ece492g1/smart-bandage/Docs/UIMockup.pdf

Logo

Email

Password

Login

Login Page

First Page of the Smart Bandage App.

Will be set up so that either the nurse or

the patient will need to enter their credentials
and the bandage ID in order to access the
information. This will provide a level of
protection of personal info in case the

phone somehow gets stolen.

Main Page BLE connection

Scan

BLE devices
Connect

Page to ensure that the Bluetooth

is connected, could probably keep
it pretty much how Jared had it.

Bandage ID

# Legend

# Smart Bandage Android Application

Box to enter requested information

Button to click

Advanced View
Temperature:
Moisture:

<Bandage ID>

Temperature reading
Moisture Level

Bandage readings are displayed here.
The temperatures will be displayed in

degrees celcius. The moisture levels will

be converted to "very dry", "dry", "damp",
"wet", "very wet". Where damp would be

the ideal moisture of the wound.

Advanced View

The advanced view would lead

into the "engineering mode" of the

app which would display the bluetooth

characteristics and the raw data.
