ece492g1/smart-bandage/(threads)

Thread 10 (2016-02-09):

Implement GATT Profiles

Mobius5150, 2016-02-09:
Setup the GATT profile with all necessary information to allow for Bluetooth communication, and test that this information can be properly read from the Android device.

Service UUID: `0xF0F0`

Service Characteristics:
 - [ ] `0xF0F1` Temperatures - RO array of 16bit integers representing 16x the temperature
 - [ ] `0xF0F2` Humidity - RO array of 16bit integers representing 16x the humidity %
 - [ ] `0xF0F3` Bandage ID - RO 16bit integer with the ID of the bandage module. `0` means no bandage detected.
 - [ ] `0xF0F4` Bandage State - RO 16bit state value with each bit representing failures on the bandage. `0` for no failure.
 - [ ] `0xF0F5` Battery Charge % - RO 16bit integer representing 16x the battery charge percentage
 - [ ] `0xF0F6` External Power - RO boolean value indicating the presence of external power
 - [ ] `0xF0F7` Moisture Map - RO array of 16bit integers representing 16x the moisture %
 - [ ] `0xF0F8` System Time - R/W 32bit integer giving system time since Unix epoch

Closed 2016-02-17.

Thread 11 (2016-02-09):

MCU Bluetooth Communications

Mobius5150, 2016-02-09:
Implement MCU Bluetooth communications. Depends on #10 being complete.

Implementation should support a handshake for confirmation of correct operation, followed by transmission of sensor data.

Closed 2016-03-02.

Thread 5 (2016-02-09):

Implement multi-threaded I2C Stack

Mobius5150, 2016-02-09:
The I2C stack should be implemented in a way that permits multi-threaded access to I2C devices.

This implies an ability to chain together any number of read and write operations to be executed sequentially in order to provide maximum compatibility with various devices. A datastructure that allows this is necessary for a multi-threaded approach.

Closed 2016-02-16.

Thread 7 (2016-02-09):

Implement HDC1050 Interface

Mobius5150, 2016-02-09:
Implement the interface for the HDC1050 Temperature + Humidity sensor using the I2C stack (#5)

This deliverable will be in two parts. The first part is due Feb 23 and requires writing the code to interface with the device from information from the datasheet, but without actually having the physical device to test with. The second is due after boards are received and the physical device can be used to test the implementation.
 - [ ] Write code and interfaces for managing the HDC1050 from datasheet information. Does not included any testing.
 - [ ] Test the implementation with physical hardware.

Closed 2016-02-29.

Thread 17 (2016-02-17):

Add I2C timeout

Mobius5150, 2016-02-17:
Add a timeout component to the I2C stack to kill a transaction if it takes too long, and then try again.

Somewhere in there there probably needs to be support for power cycling I2C devices in a bad state.

This can happen if the I2C device the MCU has addressed is not connected, or if it is in a bad state (perhaps due to a badly timed MCU reset)

Closed 2016-02-29.

Thread 31 (2016-03-16):

Add externally powered state

Mobius5150, 2016-03-16:
The device could use a state for when it is externally powered (e.g. through the USB charge port). In this state the device will constantly perform sensor readings while simultaneously being available over bluetooth.
