ece492g1/smart-bandage/hardware/bandage_module/Bandage FPC.brd

## EAGLE design hardware/bandage_module/Bandage FPC.brd (2016-03-18)

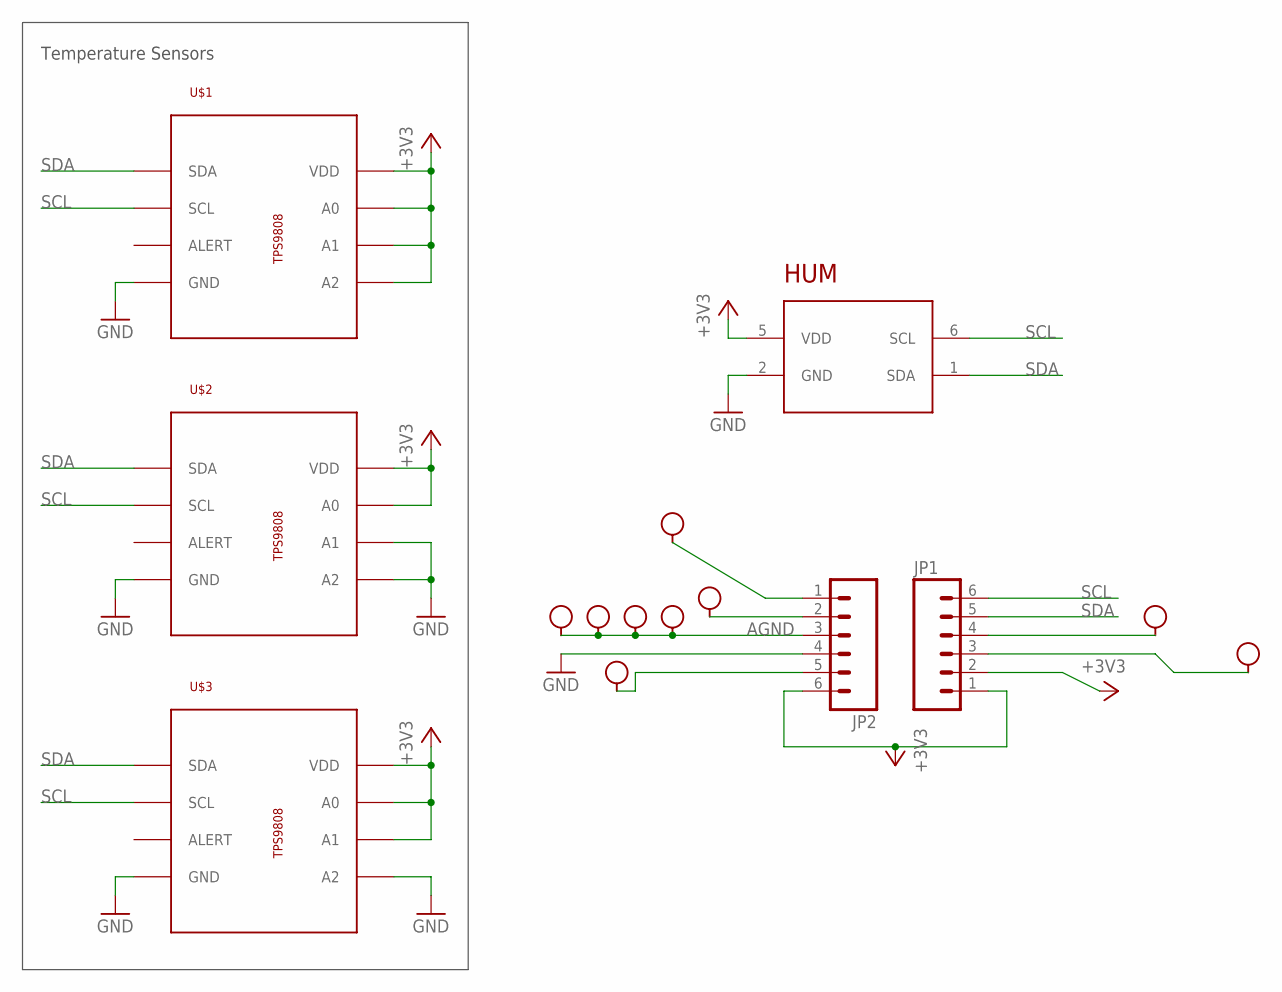
[picture p1: schematic Bandage FPC.sch]

Parts:
H1, H2, H3, H4, H5, H6, H7, H8, H9: SEW_HOLE-SMALL; SIMPLE_HOLE_SM
HUM: HDC1050; SON-6
JP1, JP2: M06LOCK; 1X06_LOCK
U$1, U$2, U$3: MCP9808; MSOP8

Connections:
+3V3: HUM.5 (VDD), JP1.1, JP1.2, JP2.6, U$1.5 (A2), U$1.6 (A1), U$1.7 (A0), U$1.8 (VDD), U$2.7 (A0), U$2.8 (VDD), U$3.6 (A1), U$3.7 (A0), U$3.8 (VDD)
AGND: H6.P$1, H7.P$1, H8.P$1, H9.P$1, JP2.3
GND: HUM.2 (GND), JP2.4, U$1.4 (GND), U$2.4 (GND), U$2.5 (A2), U$2.6 (A1), U$3.4 (GND), U$3.5 (A2)
unnamed: H2.P$1, JP1.3
unnamed: H1.P$1, JP2.5
unnamed: H4.P$1, JP2.2
unnamed: H3.P$1, JP1.4
unnamed: H5.P$1, JP2.1
SCL: HUM.6 (SCL), JP1.6, U$1.2 (SCL), U$2.2 (SCL), U$3.2 (SCL)
SDA: HUM.1 (SDA), JP1.5, U$1.1 (SDA), U$2.1 (SDA), U$3.1 (SDA)

Notes on the sheet:
Temperature Sensors

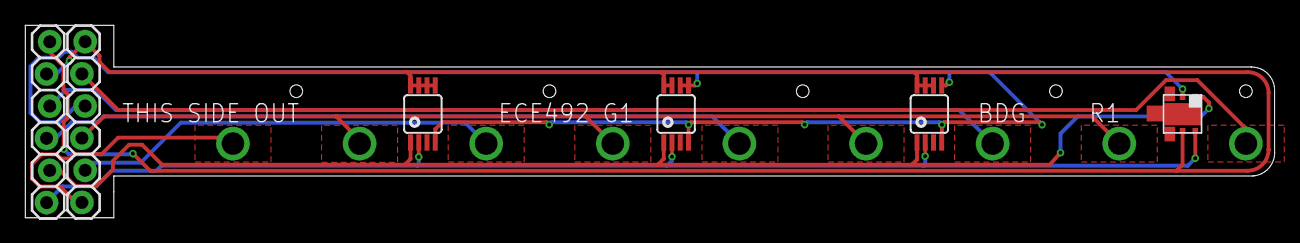
[picture p2: board Bandage FPC.brd from above]

Board: 2 copper layers, 98.7 x 15.2 mm, 15 parts (0 on the bottom side), 10 nets.
