ece492g1/smart-bandage/hardware/comms_module/Communications Board - Top.brd

## EAGLE design hardware/comms_module/Communications Board - Top.brd (2016-02-09)

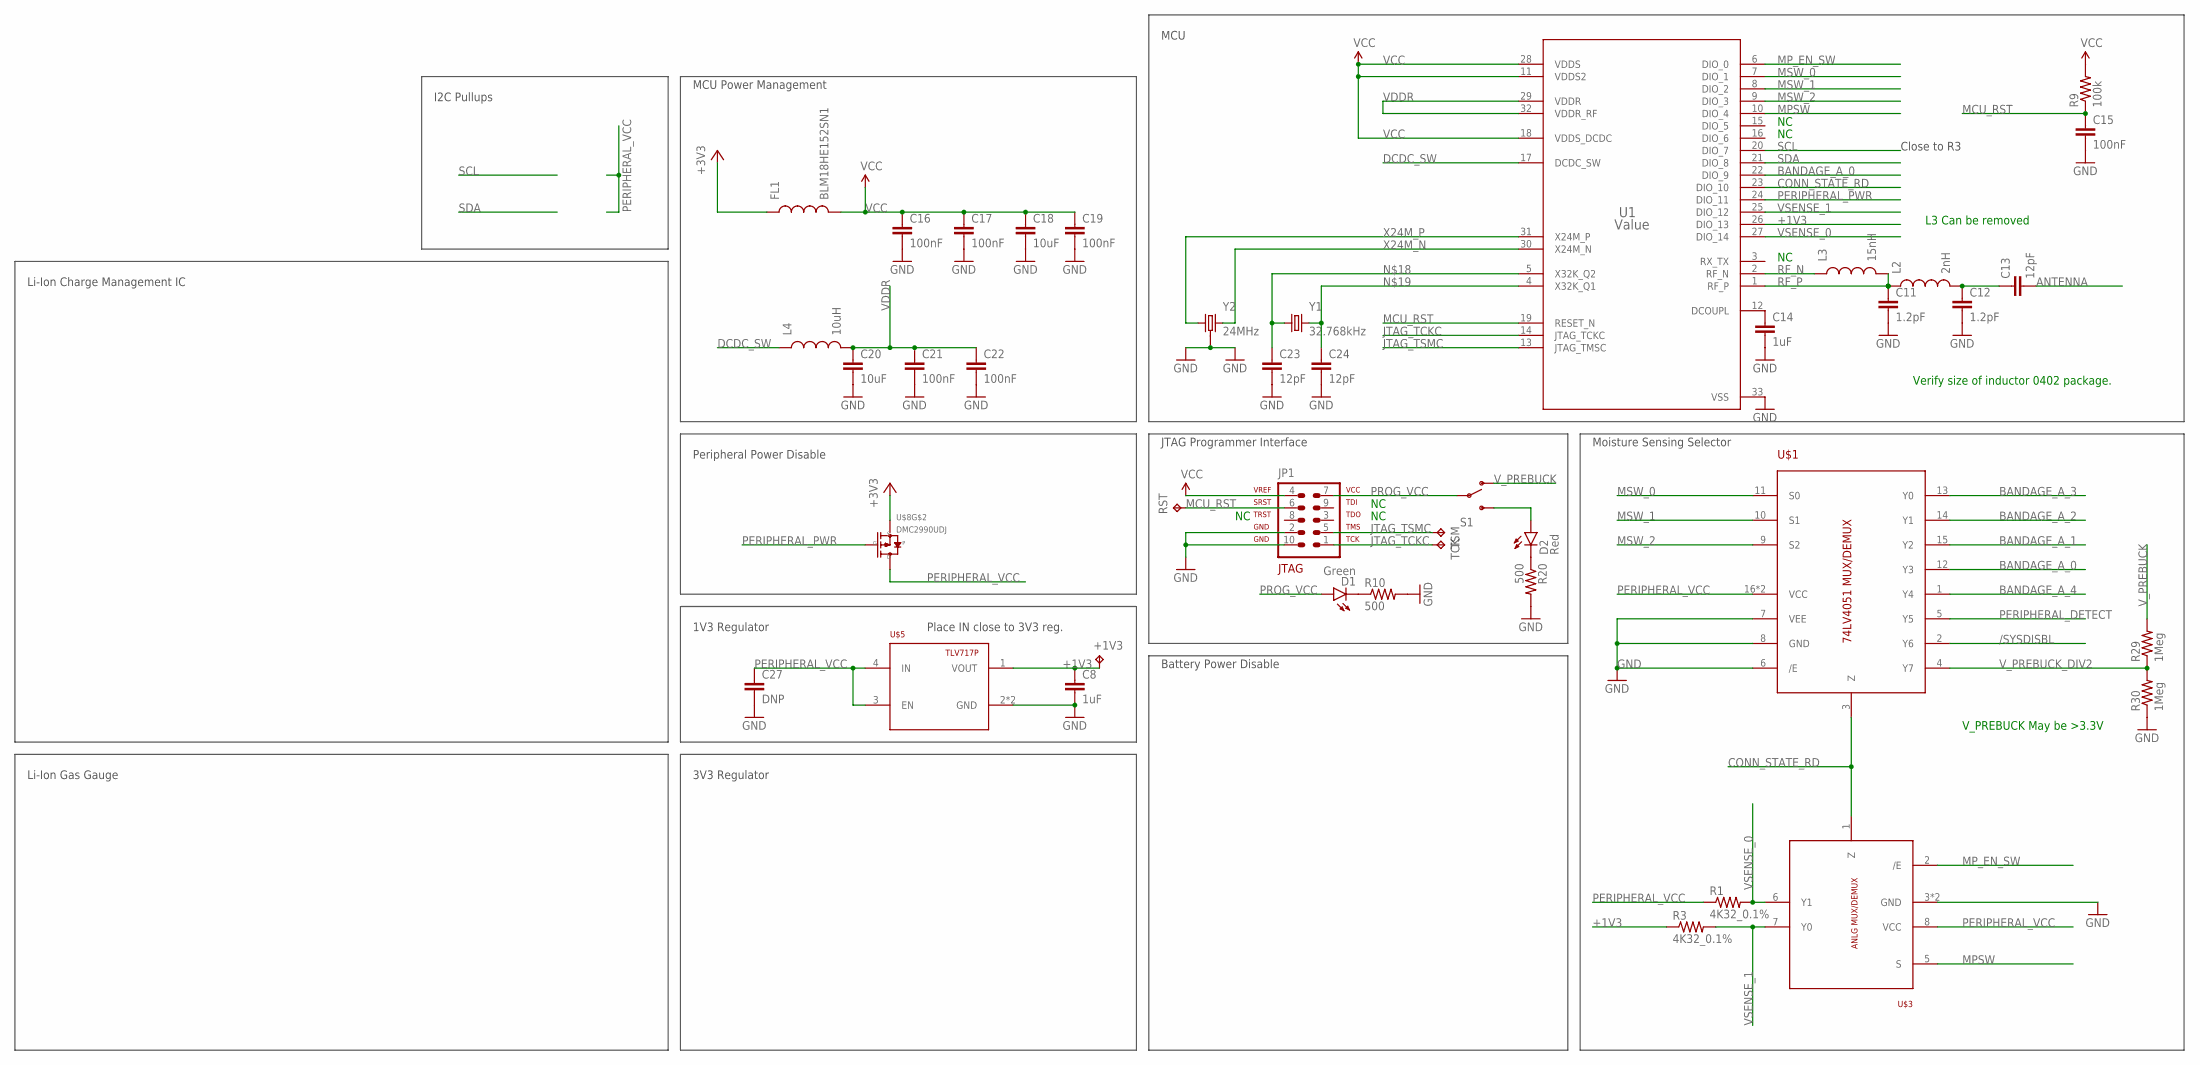
[picture p3: schematic Communications Board - Top.sch, sheet 1]

Parts:
+1V3: TPTP10R; TP10R
C8, C14: 1uF; 0402-CAP
C11, C12: 1.2pF; 0402-CAP
C13, C23, C24: 12pF; 0402-CAP
C15, C16, C17, C19, C21, C22: 100nF; 0402-CAP
C18, C20: 10uF; 0402-CAP
C27: DNP; 0402-CAP
D1: Green; LED-1206
D2: Red; LED-1206
FL1: BLM18HE152SN1; 0603
JP1: AVR-JTAG-10
L2: 2nH; C0402
L3: 15nH; C0402
L4: 10uH; 0603
R1, R3: 4K32_0.1%; 0402-RES
R9: 100k; 0603-RES
R10, R20: 500; 0603-RES
R29, R30: 1Meg; 0402-RES
RST: TPTP10R; TP10R
S1: SWITCH-SPDT; JS102011SAQN
TCK: TPTP10R; TP10R
TSM: TPTP10R; TP10R
U1: Value; RHB0032E
U$1: 74LV4051; SOT763-1
U$3: 74LVC2G53; SOT833-1
U$5: TLV717P; X2SON
U$8: DMC2990UDJ; SOT963
Y1: 32.768kHz; CRYSTAL-3.2X1.5
Y2: 24MHz; TSX-3225

Connections:
+1V3: +1V3.TP, C8.1, R3.1, U1.26 (DIO_13), U$5.1 (VOUT)
+3V3: FL1.1, U$8.4 (S); also elsewhere on the board
/SYSDISBL: U$1.2 (Y6); also elsewhere on the board
ANTENNA: C13.2
BANDAGE_A_0: U1.22 (DIO_9), U$1.12 (Y3); also elsewhere on the board
BANDAGE_A_1: U$1.15 (Y2); also elsewhere on the board
BANDAGE_A_2: U$1.14 (Y1); also elsewhere on the board
BANDAGE_A_3: U$1.13 (Y0); also elsewhere on the board
BANDAGE_A_4: U$1.1 (Y4); also elsewhere on the board
CONN_STATE_RD: U1.23 (DIO_10), U$1.3 (Z), U$3.1 (Z)
DCDC_SW: L4.1, U1.17 (DCDC_SW)
GND: C8.2, C11.2, C12.2, C14.2, C15.2, C16.2, C17.2, C18.2, C19.2, C20.2, C21.2, C22.2, C23.2, C24.2, C27.2, JP1.2, JP1.10, R10.2, R20.2, R30.1, U1.33 (VSS), U$1.6 (/E), U$1.7 (VEE), U$1.8 (GND), U$3.3 (GND), U$3.4 (GND), U$5.2 (GND), U$5.PAD (GND), Y2.2 (3), Y2.4 (3); also elsewhere on the board
JTAG_TCKC: JP1.1, TCK.TP, U1.14 (JTAG_TCKC)
JTAG_TSMC: JP1.5, TSM.TP, U1.13 (JTAG_TMSC)
MCU_RST: C15.1, JP1.6, R9.1, RST.TP, U1.19 (RESET_N)
MPSW: U1.10 (DIO_4), U$3.5 (S)
MP_EN_SW: U1.6 (DIO_0), U$3.2 (/E)
MSW_0: U1.7 (DIO_1), U$1.11 (S0)
MSW_1: U1.8 (DIO_2), U$1.10 (S1)
MSW_2: U1.9 (DIO_3), U$1.9 (S2)
unnamed: D2.A, S1.3 (S)
unnamed: D2.C, R20.1
unnamed: C23.1, U1.5 (X32K_Q2), Y1.1
unnamed: C24.1, U1.4 (X32K_Q1), Y1.2
unnamed: D1.C, R10.1
unnamed: C12.1, C13.1, L2.2
unnamed: C14.1, U1.12 (DCOUPL)
PERIPHERAL_DETECT: U$1.5 (Y5); also elsewhere on the board
PERIPHERAL_PWR: U1.24 (DIO_11), U$8.5 (G)
PERIPHERAL_VCC: C27.1, R1.1, U$1.16 (VCC), U$1.PAD (VCC), U$3.8 (VCC), U$5.3 (EN), U$5.4 (IN), U$8.3 (D); also elsewhere on the board
PROG_VCC: D1.A, JP1.7, S1.2
RF_N: L3.1, U1.2 (RF_N)
RF_P: C11.1, L2.1, L3.2, U1.1 (RF_P)
SCL: U1.20 (DIO_7); also elsewhere on the board
SDA: U1.21 (DIO_8); also elsewhere on the board
VCC: C16.1, C17.1, C18.1, C19.1, FL1.2, JP1.4, R9.2, U1.11 (VDDS2), U1.18 (VDDS_DCDC), U1.28 (VDDS); also elsewhere on the board
VDDR: C20.1, C21.1, C22.1, L4.2, U1.29 (VDDR), U1.32 (VDDR_RF)
VSENSE_0: R1.2, U1.27 (DIO_14), U$3.6 (Y1)
VSENSE_1: R3.2, U1.25 (DIO_12), U$3.7 (Y0)
V_PREBUCK: R29.2, S1.1 (O); also elsewhere on the board
V_PREBUCK_DIV2: R29.1, R30.2, U$1.4 (Y7)
X24M_N: U1.30 (X24M_N), Y2.3 (2)
X24M_P: U1.31 (X24M_P), Y2.1

Notes on the sheet:
Li-Ion Gas Gauge
Li-Ion Charge Management IC
I2C Pullups
Close to R3
3V3 Regulator
1V3 Regulator
Place IN close to 3V3 reg.
Peripheral Power Disable
Battery Power Disable
Verify size of inductor 0402 package.
L3 Can be removed
JTAG Programmer Interface
V_PREBUCK May be >3.3V
MCU Power Management
MCU
Moisture Sensing Selector

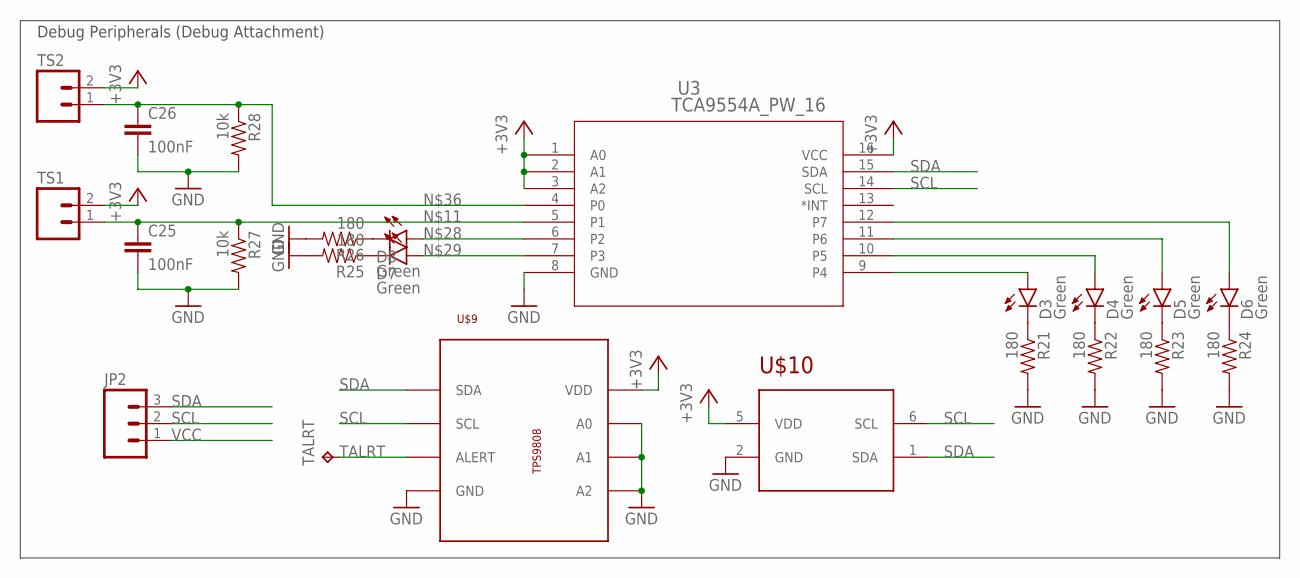
[picture p4: schematic Communications Board - Top.sch, sheet 2]

Parts:
C25, C26: 100nF; 0402-CAP
D3, D4, D5, D6, D7, D8: Green; LED-1206
JP2: M03PTH; 1X03
R21, R22, R23, R24, R25, R26: 180; 0603-RES
R27, R28: 10k; 0603-RES
TALRT: TPTP17R; TP17R
TS1, TS2: M02PTH; 1X02
U3: TCA9554A_PW_16; PW16
U$9: MCP9808; MSOP8
U$10: HDC1050; SON-6

Connections:
+3V3: TS1.2, TS2.2, U3.1 (A0), U3.2 (A1), U3.3 (A2), U3.16 (VCC), U$9.8 (VDD), U$10.5 (VDD); also elsewhere on the board
GND: C25.2, C26.2, R21.2, R22.2, R23.2, R24.2, R25.2, R26.2, R27.2, R28.2, U3.8 (GND), U$9.4 (GND), U$9.5 (A2), U$9.6 (A1), U$9.7 (A0), U$10.2 (GND); also elsewhere on the board
unnamed: D3.A, U3.9 (P4)
unnamed: C25.1, R27.1, TS1.1, U3.5 (P1)
unnamed: D4.A, U3.10 (P5)
unnamed: D5.A, U3.11 (P6)
unnamed: D6.A, U3.12 (P7)
unnamed: D8.A, U3.6 (P2)
unnamed: D7.A, U3.7 (P3)
unnamed: D3.C, R21.1
unnamed: D4.C, R22.1
unnamed: D5.C, R23.1
unnamed: D6.C, R24.1
unnamed: D7.C, R25.1
unnamed: D8.C, R26.1
unnamed: C26.1, R28.1, TS2.1, U3.4 (P0)
SCL: JP2.2, U3.14 (SCL), U$9.2 (SCL), U$10.6 (SCL); also elsewhere on the board
SDA: JP2.3, U3.15 (SDA), U$9.1 (SDA), U$10.1 (SDA); also elsewhere on the board
TALRT: TALRT.TP, U$9.3 (ALERT)
VCC: JP2.1; also elsewhere on the board

Notes on the sheet:
Debug Peripherals (Debug Attachment)

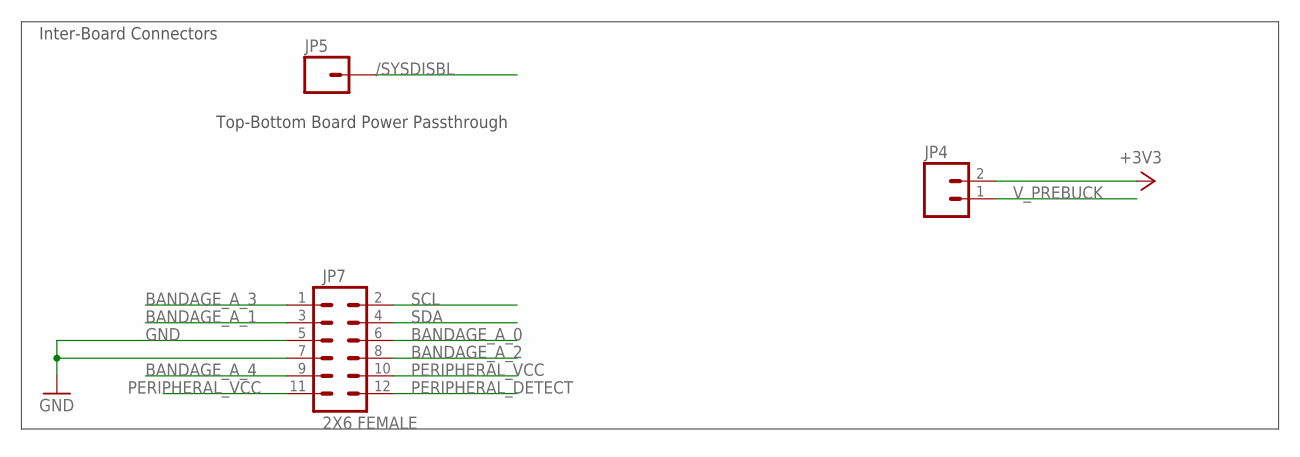
[picture p5: schematic Communications Board - Top.sch, sheet 3]

Parts:
JP4: M021X02_NO_SILK; 1X02_NO_SILK
JP5: M01PTH; 1X01
JP7: 2X6 FEMALE; 2X6

Connections:
+3V3: JP4.2; also elsewhere on the board
/SYSDISBL: JP5.1; also elsewhere on the board
BANDAGE_A_0: JP7.6; also elsewhere on the board
BANDAGE_A_1: JP7.3; also elsewhere on the board
BANDAGE_A_2: JP7.8; also elsewhere on the board
BANDAGE_A_3: JP7.1; also elsewhere on the board
BANDAGE_A_4: JP7.9; also elsewhere on the board
GND: JP7.5, JP7.7; also elsewhere on the board
PERIPHERAL_DETECT: JP7.12; also elsewhere on the board
PERIPHERAL_VCC: JP7.10, JP7.11; also elsewhere on the board
SCL: JP7.2; also elsewhere on the board
SDA: JP7.4; also elsewhere on the board
V_PREBUCK: JP4.1; also elsewhere on the board

Notes on the sheet:
Top-Bottom Board Power Passthrough
Inter-Board Connectors

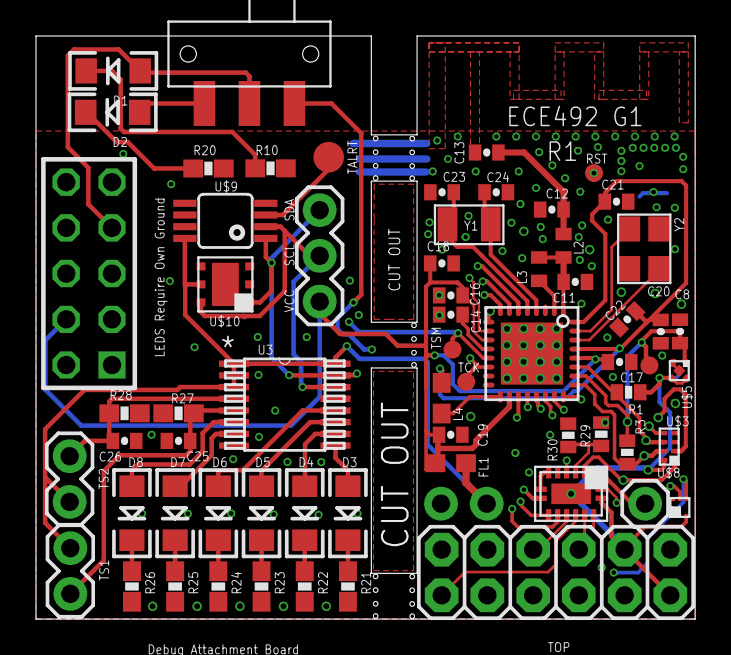
[picture p6: board Communications Board - Top.brd from above]

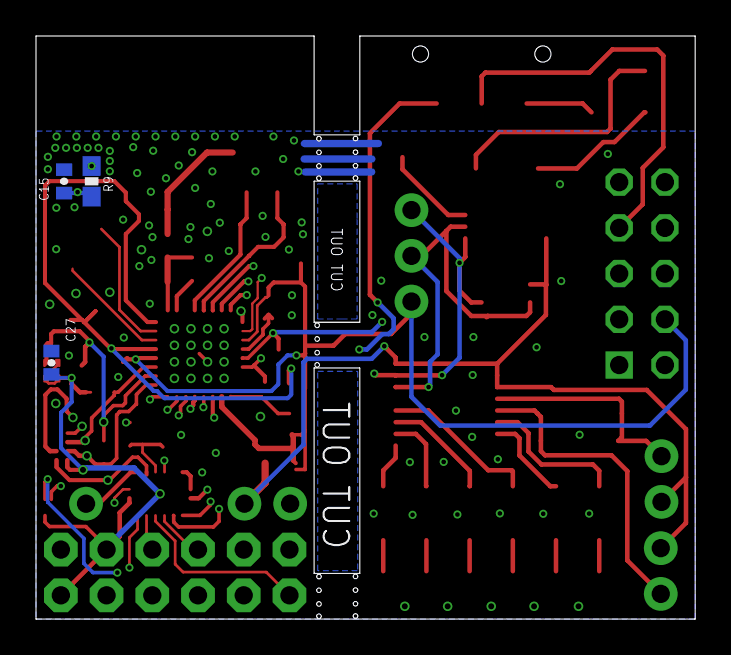
[picture p7: board Communications Board - Top.brd from below]

Board: 4 copper layers, 36.6 x 32.4 mm, 68 parts (3 on the bottom side), 57 nets.
