ece492g1/smart-bandage/hardware/comms_module/Communications Board - Bottom.brd

## EAGLE design hardware/comms_module/Communications Board - Bottom.brd (2016-02-09)

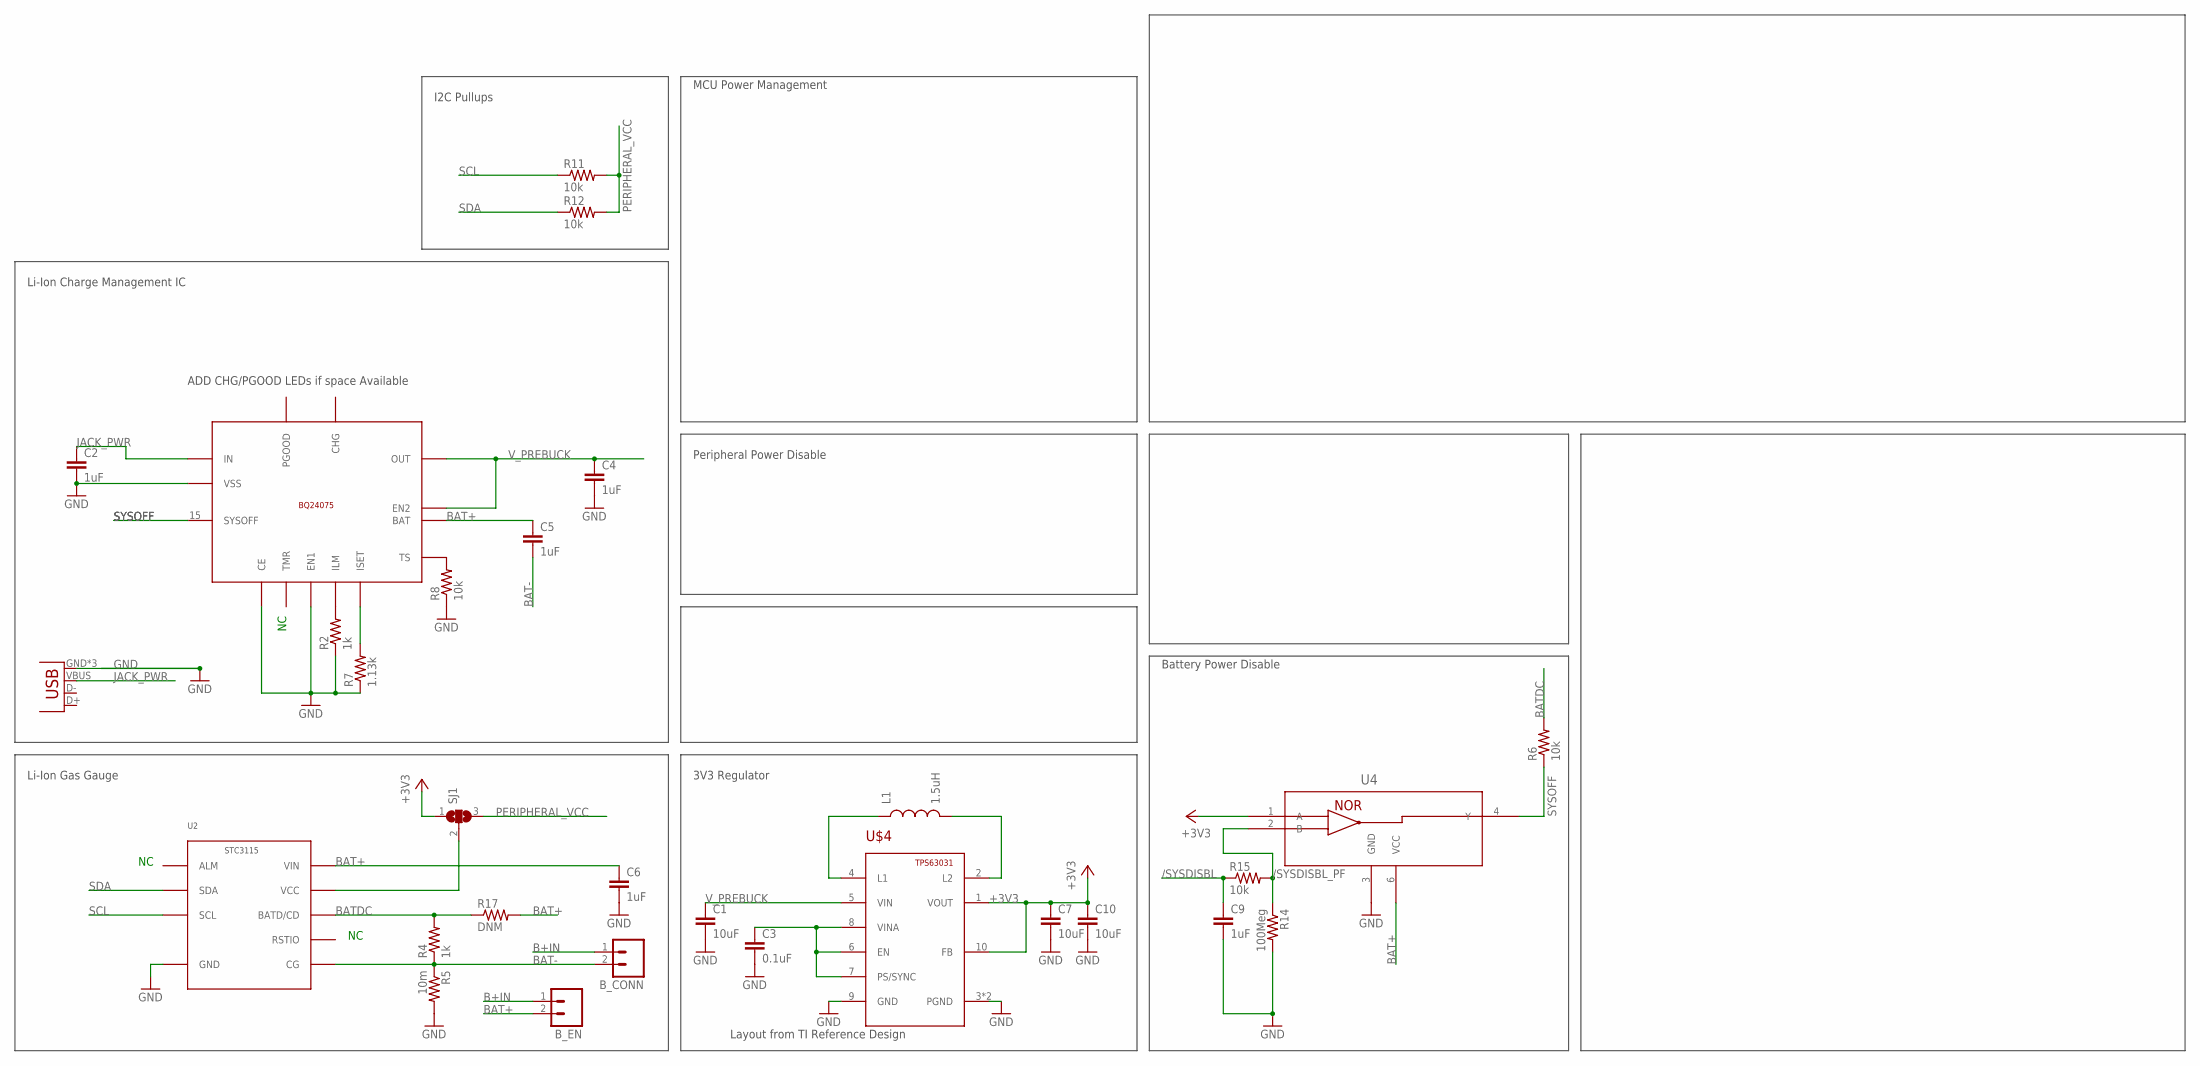
[picture p8: schematic Communications Board - Bottom.sch, sheet 1]

Parts:
B_CONN: M02PTH; 1X02
B_EN: M02PTH; 1X02
C1, C7: 10uF; 0402-CAP
C2, C4, C5, C6, C9: 1uF; 0603-CAP
C3: 0.1uF; 0402-CAP
C10: 10uF; 0603-CAP
L1: 1.5uH; IND1212
R2, R4: 1k; 0603-RES
R5: 10m; 0603-RES
R6, R8, R11, R12, R15: 10k; 0603-RES
R7: 1.13k; 0603-RES
R14: 100Meg; 0603-RES
R17: DNM; 0603-RES
SJ1: SJ2W; SJ_2
U2: STC3115; DFN10-2X3
U4: SN74AUP1G02_DSF_6; DSF6
U$2: BQ24075; QFN16-3X3MM
U$4: TPS63031; SON-10
X2: USB-MICROB

Connections:
+3V3: C7.1, C10.1, SJ1.1, U4.1 (A), U$4.1 (VOUT), U$4.10 (FB); also elsewhere on the board
/SYSDISBL: C9.1, R15.1; also elsewhere on the board
/SYSDISBL_PF: R14.1, R15.2, U4.2 (B)
B+IN: B_CONN.1, B_EN.1
BAT+: B_EN.2, C5.1, C6.1, R17.2, U2.P10 (VIN), U4.6 (VCC), U$2.2 (BAT), U$2.3 (BAT)
BAT-: B_CONN.2, C5.2, R4.1, R5.1, U2.P6 (CG)
BATDC: R4.2, R6.2, R17.1, U2.P8 (BATD/CD)
GND: C1.2, C2.2, C3.2, C4.2, C6.2, C7.2, C9.2, C10.2, R2.1, R5.2, R7.1, R8.1, R14.2, U2.P5 (GND), U4.3 (GND), U$2.4 (CE), U$2.6 (EN1), U$2.8 (VSS), U$2.EXT (VSS), U$4.3 (PGND), U$4.9 (GND), U$4.PAD (PGND), X2.GND, X2.MT1 (GND), X2.MT2 (GND); also elsewhere on the board
JACK_PWR: C2.1, U$2.13 (IN), X2.VBUS
unnamed: L1.P$1 (1), U$4.4 (L1)
unnamed: L1.P$2 (2), U$4.2 (L2)
unnamed: C3.1, U$4.6 (EN), U$4.7 (PS/SYNC), U$4.8 (VINA)
unnamed: R8.2, U$2.1 (TS)
unnamed: R2.2, U$2.12 (ILM)
unnamed: R7.2, U$2.16 (ISET)
unnamed: SJ1.2, U2.P9 (VCC)
PERIPHERAL_VCC: R11.2, R12.2, SJ1.3; also elsewhere on the board
SCL: R11.1, U2.P3 (SCL); also elsewhere on the board
SDA: R12.1, U2.P2 (SDA); also elsewhere on the board
SYSOFF: R6.1, U4.4 (Y), U$2.15 (SYSOFF)
V_PREBUCK: C1.1, C4.1, U$2.5 (EN2), U$2.10 (OUT), U$2.11 (OUT), U$4.5 (VIN); also elsewhere on the board

Notes on the sheet:
Li-Ion Gas Gauge
Li-Ion Charge Management IC
I2C Pullups
Layout from TI Reference Design
3V3 Regulator
Peripheral Power Disable
Battery Power Disable
ADD CHG/PGOOD LEDs if space Available
MCU Power Management

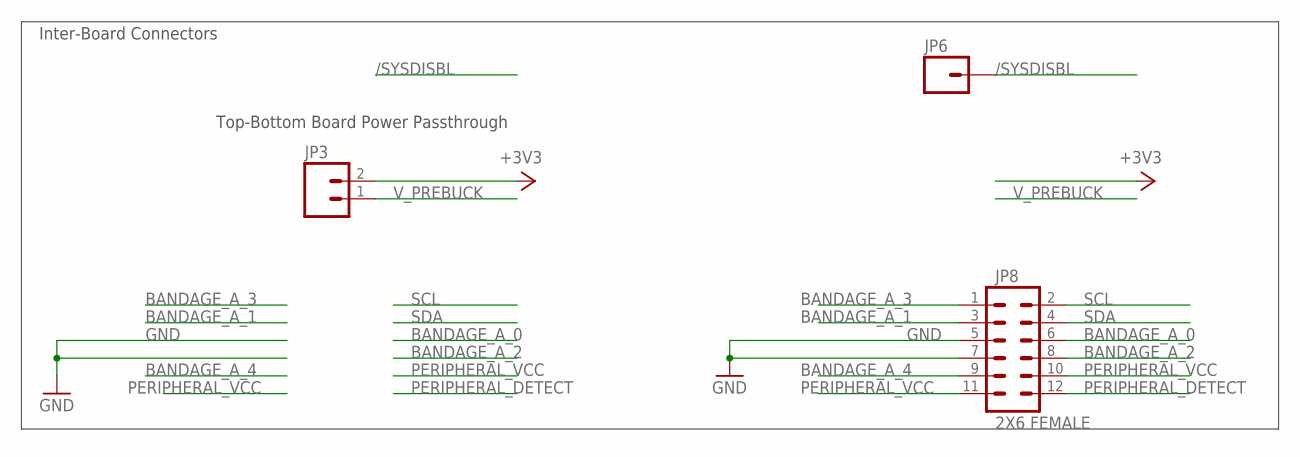
[picture p9: schematic Communications Board - Bottom.sch, sheet 3]

Parts:
JP3: M021X02_NO_SILK; 1X02_NO_SILK
JP6: M01PTH; 1X01
JP8: 2X6 FEMALE; 2X6

Connections:
+3V3: JP3.2; also elsewhere on the board
/SYSDISBL: JP6.1; also elsewhere on the board
BANDAGE_A_0: JP8.6
BANDAGE_A_1: JP8.3
BANDAGE_A_2: JP8.8
BANDAGE_A_3: JP8.1
BANDAGE_A_4: JP8.9
GND: JP8.5, JP8.7; also elsewhere on the board
PERIPHERAL_DETECT: JP8.12
PERIPHERAL_VCC: JP8.10, JP8.11; also elsewhere on the board
SCL: JP8.2; also elsewhere on the board
SDA: JP8.4; also elsewhere on the board
V_PREBUCK: JP3.1; also elsewhere on the board

Notes on the sheet:
Top-Bottom Board Power Passthrough
Inter-Board Connectors

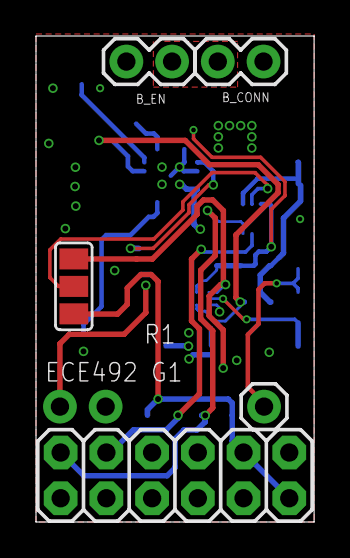
[picture p10: board Communications Board - Bottom.brd from above]

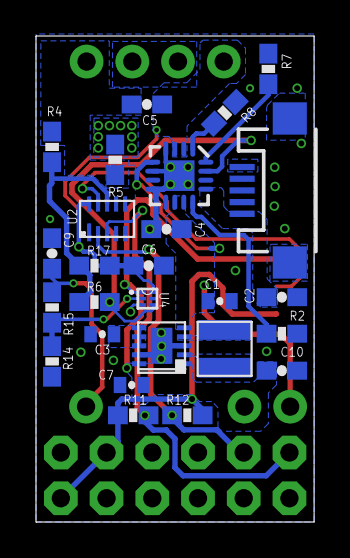
[picture p11: board Communications Board - Bottom.brd from below]

Board: 4 copper layers, 15.4 x 27.0 mm, 32 parts (26 on the bottom side), 21 nets.
