ece492g1/smart-bandage/software/comms_module/SmartBandage/Application/fsm.h

#ifndef SB_FSM_H
#define SB_FSM_H

#include "hci_tl.h"
#include "Board.h"

//main states for the state machine for the mcu
typedef enum {
	S_SLEEP,
	S_CHECK,
	S_TRANSMIT,
	S_ERROR_TEMP,
	S_ERROR_PERM,
	S_INIT,

	// This element should be left -- gives self-correcting code for the correct number of states supported
	SB_NUM_STATES
} SB_State;
 
//main event definitins, things that will trigger a transition
//data change is equivalent to an alert
typedef enum {
	E_CHECK_TIMER_EXPIRED,
	E_BLE_TIMER_EXPIRED,
	E_DATA_CHANGE,
	E_NO_BANDAGE_DETECTED,
	E_ERROR,

	// This element should be left -- gives self-correcting code for the correct number of states supported
	SB_NUM_EVENTS
} SB_Event;

// the transition stages of the state machine for the mcu
typedef enum {
	T_STATE_ENTER,
	T_STATE_PRE_ENTER,
	T_STATE_EXIT,
	T_STATE_PRE_EXIT,
} SB_State_Transition;

typedef void (*SB_StateTransitionCallbackFunc)(SB_State_Transition, SB_State);

struct SB_CallbackFunc_struct;
struct SB_CallbackFunc_struct {
	struct SB_CallbackFunc_struct *next;
	SB_StateTransitionCallbackFunc function;
	SB_State_Transition transition : 2;
	SB_State state : 6;
};
typedef struct SB_CallbackFunc_struct SB_CallbackFunc;

typedef struct {
	SB_State lastState;
	SB_State currentState;
	SB_Event lastEvent;
	SB_Error currentError;
	SB_Error lastError;
} SB_SystemState;

SB_State SB_switchState(SB_State);
SB_Event SB_getNewEvent(void);
SB_State SB_handleEvent(SB_Event);
SB_State SB_currentState();
SB_Error SB_registerStateTransitionCallback(SB_StateTransitionCallbackFunc function, SB_State_Transition transition, SB_State state);

#endif
