ece492g1/smart-bandage/(commit log)

2016-01-16 Initial commit of WIP board files.
    [Communications Board.brd, Communications Board.sch]
2016-01-18 Add MUXes and moisture detection schematics.
    [Communications Board.brd, Communications Board.sch]
2016-01-18 Add power management components.
    [Communications Board.brd, Communications Board.sch]
2016-01-19 Fix STC3115 Vcc connection
    [Communications Board.brd, Communications Board.sch]
2016-01-21 Add bandage module. Add HDC1050 to lib.
    [Bandage FPC.brd, Bandage FPC.sch]
2016-01-27 Add remaining components and start board layout.
    [Bandage FPC.brd, Bandage FPC.sch, Communications Board.brd, Communications Board.sch]
2016-01-27 Continued routing of the communications board.
    [Communications Board.brd, Communications Board.sch]
2016-01-28 Continued routing of top and bottom.
    [Communications Board.brd, Communications Board.sch]
2016-01-29 Convert to 4 layer. Nearly complete routing.
    [Communications Board.brd, Communications Board.sch]
2016-01-31 App PCB Trace Antenna
    [Communications Board.brd]
2016-01-31 Nearly complete routing. Add programming interface.
    [Communications Board.brd, Communications Board.sch]
2016-02-01 Continued routing of signals.
    [Communications Board.brd]
2016-02-01 Add programming attachment board.
    [Communications Board.brd, Communications Board.sch]
2016-02-01 Complete programming/debug attachment board.
    [Communications Board.brd, Communications Board.sch]
2016-02-02 Create muiltiple schematic sheets, and organize
    [Communications Board.brd, Communications Board.sch]
2016-02-03 Update CC2650 part for batter pad sizing.
    [Communications Board.brd, Communications Board.sch]
2016-02-03 Add extra cap footprint for the 1V3 regulator.
    [Communications Board.brd, Communications Board.sch]
2016-02-07 Fixes from PCB review session.
    [Communications Board.brd, Communications Board.sch]
2016-02-09 Replace poweroff circuit with NOR gate.
    [Communications Board.brd, Communications Board.sch]
2016-02-09 Finish routing of modified boards.
    [Communications Board.brd, Communications Board.sch]
2016-02-09 Adding final version before split.
    [Communications Board.brd, Communications Board.sch]
2016-02-09 Adding broken-out versions of top and bottom boards as ordered.
    [Communications Board - Bottom.brd, Communications Board - Bottom.sch, Communications Board - Top.brd, Communications Board - Top.sch]
2016-02-09 Importing base TI RTOS/BLE Project.
    Based off of the `SimpleBLEPeripheral` Example Project.
    [appBLE.cfg]
2016-02-10 Adding and Configuring I2C driver, board settings
    [appBLE.cfg]
2016-02-10 Fix I2C port numbers.
    [config.h]
2016-02-12 Add the I2C code and headers for MCP9808.
    The I2C code implements a multi-threaded I2C interface.
    The MCP9808 headers are not complete. It could likely use some convenience
    functions, and some functions for the configuration.
    See #5, #6
    [appBLE.cfg]
2016-02-12 Increase I2C frequency to 400kHz
2016-02-12 Add LED status indication to I2C temp read
    For a demonstration of PIN interfacing.
2016-02-16 Have bluetooth working with SimpleBLEPeripheral
    Integrated the SimpleBLEPeripheral code with the project code and got
    things working. Can see the temperature sensor being read, and can read
    the canned attributes from the device.
2016-02-17 Read temperature over bluetooth.
    See #11, #10, #6
2016-02-18 Add STC3115 device header to project.
    Added a struct for the device that allows easily reading/writing the
    device.
2016-02-18 Configuration code for HDC1050, improve sensor defs
2016-02-18 Fix small peripheral manager bug
    [Board.h, peripheralManager.c]
2016-02-20 Fix writing multibyte values for system time
    [smartBandageProfile.c]
2016-02-27 Add defines for running properly on the actual PCB
2016-02-27 Add peripheral management functions
    Add functions for managing external peripheral power
    Add functions for managing external MUXs and selecting desired
    inputs/outputs #13
    Configure input pins used by/for peripherals
2016-02-27 Add draft i2c timeout code
2016-02-27 fixed compile issue, still skeleton
    [fsm.c]
2016-02-28 Fix nasty bug in ICall framework, inc. heap
    Fixed a nasty bug in the ICall framework on line 1241 of ICall.c wherein
    it was trying to start a timer with timeout 0 (not allowed) and getting
    stuck in an ON error loop. This fix doesn't fix whatever was causing this,
    but afterwards it all seems to work.
    Increased the size of the heap because we were running out. Commented out
    FSM.c. We don't have enough memory for that function pointer struct
    unfortunately.
    [appBLE.cfg]
2016-02-28 seg fault, line 197..fix it
    [fsm.c]
2016-02-28 Opt. memory. Restructure pmanager code optimally.
    Optimized memory by reducing extra semaphores, reduce I2C stack size (it
    doesn't change much), and set the compiler to optimization level 5.
    Restructured the peripheral manager code so that it configures each device
    and starts its conversion cycle on each cycle, which is more akin to what
    we'll see with proper power management. This method also optimally
    interweaves the conversion time for all of the devices with other
    operations.
    Closes #19 #17 #7
    [Board.h, hdc1050.h, i2c.c, peripheralManager.c, peripheralManager.h, tca9554a.c, tca9554a.h]
2016-02-28 Adding final draft of FPC
    [Bandage FPC.brd, Bandage FPC.sch]
2016-03-02 added in preventing of context switching for tasks while going through callbacks in linked list
    [fsm.c]
2016-03-03 Adding final version of the FPC board
    [Bandage FPC.brd]
2016-03-16 Lay groundwork for flash NV storage module
    Started writing a custom flash manager as the built in osal nv stuff only
    allows for two pages (8k).
2016-03-16 Add work on flash and STC3115
    [appBLE.cfg]
2016-03-16 Add finalized STC3115 structures.
    Cannot yet read correct battery SOC.
    See #8
    [peripheralManager.c, stc3115.c, stc3115.h]
2016-03-16 Defined historical data bluetooth characteristics.
    Not fully hooked up yet, but readable from a bluetooth device. Had to
    reduce task stacks further to make room.
    See #15
2016-03-16 Work on the notification of BLE attributes.
    This commit contains the showstopper bluetooth I believe is caused by
    talking to the bluetooth stack from the peripheral manager task as opposed
    to a thread registered through ICall
    [appBLE.cfg]
2016-03-16 Support notifications for readings.
    Seems to work properly, however android oftentimes does not receive
    notification after either connect/disconnect or reading/writing any other
    characteristic. Unclear where the bug is.
    [appBLE.cfg]
2016-03-16 Remove commented code and wasted stack space
    [appBLE.cfg]
2016-03-20 Integrate FSM with system and work on better bluetooth connection
    [appBLE.cfg]
2016-03-21 Have working analog reading from bandage module.
    May be missing inputs/not reporting them
    [Board.h, bandage.c, bandage.h, fsm.c, peripheralManager.c, peripheralManager.h]
2016-03-22 Add base implementation of clock module.
    Not yet tested.
    [appBLE.cfg]
2016-03-24 Code cleaning. Flash blue LED when in transmit
2016-03-31 Fix timestamps and remove reading ref time field
    Reading reference time now reported as first 4 bytes of `Readings`.
    [appBLE.cfg]
2016-04-01 Fix power mgmt output
    [Board.c, Board.h, bandage.c, peripheralManager.c]
2016-04-04 Fix improper behaviour when setting timestamp the first time.
    Flash manager should have considered the time diff of the _last_ value not
    the first one.
    [Board.c, Board.h, ble.c, flash.c, flash.h, peripheralManager.c, readingsManager.c, readingsManager.h]
