ece492g1/smart-bandage/(notices)

Notices in the files:
parts and their libraries:
LilyPad-Wearables: Licensing:Creative Commons ShareAlike 4.0 International - https://creativecommons.org/licenses/by-sa/4.0
SparkFun: Licensing: CC v3.0 Share-Alike You are welcome to use this library for commercial purposes.
